vitoria-ribas/megatron/(commit log)

2026-10-27 docs: atualiza documentação com o que foi implementado
2026-10-27 chore: reduz o log de distância no Monitor Serial
    Imprime a leitura frontal só a cada INTERVALO_LOG_MS ou quando há obstáculo.
2026-10-27 fix: conta no mapa a célula percorrida pela metade ao parar
    Antes, o tempo de avanço desde a última célula era descartado quando o robô parava,
    e o mapa registrava menos deslocamento do que o real.
    [Navigation.cpp]
2026-10-27 fix: marca como livre a célula visitada mesmo que fosse obstáculo
    Com a pose estimada por tempo, um obstáculo pode cair numa célula por onde o robô
    passa depois; a visita física prevalece.
    [GridMap.cpp]
2026-10-27 refactor: move pausas e margens fixas da navegação para o Config.h
    Sem mudança de valores: 100 ms e 150 ms ao redor das manobras, 500 ms para zerar
    as rés e 5 cm de margem de empate entre os lados.
    [Config.h, Navigation.cpp]
2026-10-27 docs: adiciona README e aviso sobre os pinos de boot GPIO12 e GPIO2
    Atualiza o LEIA_PRIMEIRO com o novo comportamento do mapa e do log.
2026-10-27 feat: conta as passagens por célula e mostra a direção do robô no mapa
    Cada célula livre guarda quantas vezes o robô passou por ela e o mapa imprime esse
    número (1 a 9) em vez de 'o'. O robô aparece como ^ > v < conforme o sentido.
2026-10-27 feat: desvia de áreas já visitadas durante o avanço
    Ao entrar numa célula visitada LIMITE_REVISITAS vezes, o robô para, olha os lados e
    vira para um lado livre que leve a uma área menos explorada (mais células
    desconhecidas e, em empate, menos passagens). A escolha de lado diante de obstáculo
    usa o mesmo critério. EVITAR_REPETICAO = false volta ao comportamento anterior.
2026-10-27 feat: imprime métricas da exploração em CSV (linhas STATS)
    A cada impressão do mapa sai uma linha STATS com tempo, células visitadas,
    revisitas, obstáculos, giros, rés e desvios por repetição, para a análise do
    comportamento no relatório.
2026-10-27 docs: adiciona documentação técnica com arquitetura, algoritmos e roteiro de testes
    Explica o mapa, o anti-repetição e as linhas STATS, e traz uma tabela de testes em
    branco para a análise do relatório. Atualiza o LEIA_PRIMEIRO e o README.
2026-10-27 fix: não avança quando o sensor perde o eco colado num obstáculo
    O HC-SR04 fica sem eco com o objeto muito perto ou inclinado, e o avanço tratava
    isso como caminho livre. Agora, sem eco logo depois de uma leitura frontal de até
    ECO_PERDIDO_PERTO_CM conta como muito perto: o robô para e recua.
    [Config.h, Navigation.cpp, Navigation.h]
2026-10-27 fix: varre os lados depois da ré em vez de girar às cegas
    Com o obstáculo a até 10 cm, o robô só recuava e saía da análise, então o servo
    não girava e, após duas rés, ele virava sem olhar. Agora recua, varre os lados e
    escolhe a direção; depois da ré não volta a seguir em frente.
    [Navigation.cpp]
2026-10-27 feat: adiciona log de depuração e teste do servo para diagnosticar o travamento
    DEPURAR imprime cada comando de servo e de motor com o horário, mostrando se o
    servo foi mandado para a frente antes de as rodas girarem. TESTE_SERVO varre o
    servo ao ligar com os motores parados e depois girando, para separar falha de
    alimentação de falha de lógica. O LEIA_PRIMEIRO explica como usar.
2026-10-27 fix: põe as mudanças de comportamento atrás de chaves, desligadas por padrão
    Com o código da main o robô funciona e com a polimento não. Até achar a causa,
    VARRER_APOS_RE, REGRA_ECO_PERDIDO e EVITAR_REPETICAO ficam desligadas no
    Config.h e o robô se move como na main, mantendo mapa com visitas, STATS e log.
    Ligue uma por vez para encontrar a mudança responsável.
    [Config.h, Navigation.cpp]
2026-10-29 fix: remove a parada do anti-repetição e liga as chaves testadas no robô
    No teste com o protótipo, parar para varrer ao entrar em área já visitada fazia o
    robô girar demais e travar em espaço apertado; esse trecho e suas chaves saem. A
    escolha de lado continua preferindo a área mais desconhecida e, em empate, a
    menos visitada. VARRER_APOS_RE e REGRA_ECO_PERDIDO funcionaram no robô e passam
    a vir ligadas. O teste do servo agora mede a distância em cada ângulo.
    [Config.h, GridMap.cpp, GridMap.h, Navigation.cpp, Navigation.h, megatron.ino]
